ClaudeMarais/AlfaRomeoGiulia_DashboardInfo_ESP32-S3/README.md

# Display info on dashboard of Alfa Romeo Giulia using ESP32-S3
 
An Arduino project to display useful information like turbo boost pressure, current gear, performance tune status, etc., directly on the dashboard of an Alfa Romeo Giulia. The information is displayed in the location on the instrument cluster where the infotainment information is normally displayed, e.g. displaying the radio station name.

A big thank you to the Alfisti community for reverse enginering some of these PIDs, especially Gaucho https://github.com/gaucho1978/BACCAble

| Example Message | Description |
|---|---|
| 23 psi &nbsp; D2 &nbsp; Eng 200*F | While driving, show turbo boost pressure, current gear and engine temp |
| 23 psi &nbsp; D2 &nbsp; Oil 200*F | While driving, show turbo boost pressure, current gear and engine oil temp |
| 23 psi &nbsp; D2 &nbsp; Bat 12.6V | While driving, show turbo boost pressure, current gear and battery voltage |
| 23 psi &nbsp; D2 &nbsp; Squadra | If in Dynamic drive mode and oil temp is above 70*C, the Squadra performance tune is fully enabled |
| Max 23 psi @ 5200 rpm D2 | When car is just idling, e.g. at red traffic light, show interesting information when max turbo boost was measured |
| Battery is low! &nbsp;12.2V | A warning message when the car battery is lower than 12.4V |
| Careful, engine is cold | A warning message when engine speed is higher than 3000 RPM while the engine oil temperature is below 70*C |
| Eng temp too high 248*F | A warning message when the engine coolant temperature is too high (above 120*C / 248*F) |
| Oil temp too high 275*F | A warning message when the engine oil temperature is too high (above 135*C / 275*F) |
| Turbo cooling down 1:12 | A countdown timer roughly estimating for how long the car has to idle for a turbo cooldown after a spirited drive  |

Car data like RPM and boost pressure can be retrieved from the high speed CAN bus, but sending text to the dashboard uses the low speed CAN bus. Since one CAN controller can only communicate on one CAN bus, we require two CAN controllers. The ESP32-S3 has a built-in CAN controller, so we connect a SN65HVD230 CAN transceiver to the ESP32-S3 which communicates on the high speed bus. A separate MCP2515 CAN bus controller with its own TJA1050 transceiver is used to communicate on the low speed CAN bus. The ESP32-S3 has two cores, so it's convenient to continuously collect car data on one core from the high speed CAN bus, while at the same time send information to the dashboard on the low speed CAN bus using the other ESP32-S3 core.

The OBD2 connector has an always-on 12V pin where the device will be powered from. Since it's always on, it will unnecessarily draw power when the car is turned off. One option would be to just always unplug the device when not driving, another might be to add a button to the device to manually switch it on/off. In this project, we simply detect if the car is turned on and if not, we put the device into deep sleep mode to heavily reduce the amount of power used. We'll check for 5 seconds if the car is on, then sleep for 12 seconds, etc. While trying to see if the car turns on, the device will draw ~40mA/190mW, but only ~1mA/1mW while in deep sleep.

NOTE: If you intend to experiment and make your own code changes, I recommend enabling the C++ define for DISABLE_POWER_SAVING_CHECKS found in the file AlfaRomeoGiulia_DashboardInfo_ESP32-S3.ino. If not, the device will go into deep sleep and you might struggle to upload code to the device, since you have to time it just right. When the device is powered on by plugging it into the computer's USB port, you have 5 seconds before it goes into deep sleep. You want to have the device awake while the code is being uploaded. When using the Arduino IDE, I find that if you unplug the device from your computer's USB port, then wait for the message in the Output window that says "Linking everything together...", and then quickly plug the device into your computer's USB port, it gives enough time for the device to stay awake to upload the code.

NOTE: It's fun to tinker with your car, but there is always a chance to mess things up. I won't be liable if for some reason you damage your car.

NOTE: The CAN IDs and PIDs used in this project specifically work with a 2019 Alfa Romeo Giulia 2.0L (Petrol). It's highly unlikely that the same PIDs will work with another car, you'll have to research what PIDs work with your own car.

Some tips:

 - Consider connecting your car to a battery charger while experimenting. It's highly likely that you'll spend several hours in your car while the battery is being drained.
 - Diagrams of OBD2 pins are normally shown for the female connector in your car. Don't forget that those pins are in swapped/mirrored positions on the male connector.
 - The OBD2 connector has an "always on" 12V pin. Make sure the wire connecting to that pin on your male connector isn't exposed so that it cannot touch other wires!
 - I tried multiple pins on the ESP32-S3 to connect to the SN65HVD230, but only D4/D5 worked for me. Coincidentally these are also the SDA/SCL pins.
 - Check if your car has an OBD2 Security Gateway (SGW). If so, you need to install a SGW Bypass module before you to send/receive OBD2 frames to your car.
 - For 3D printing, use something like PETG or TPU which is much more resistant to heat than PLA.

Hardware:
 - XIAO ESP32-S3
 - 12V to 5V Voltage regulator
 - SN65HVD230 CAN bus transceiver
 - MCP2515 CAN bus controller

Arduino libraries used:
 - ESP32-TWAI-CAN: https://github.com/handmade0octopus/ESP32-TWAI-CAN
 - MCP2515: https://github.com/codeljo/AA_MCP2515

If you are unfamiliar with Arduino, it’s pretty simple and there is a multitude of small tutorials on the internet. At a high level, you will need to:
-	Install the Arduino IDE - https://www.arduino.cc/en/software
-	Configure Arduino IDE for ESP32 - https://randomnerdtutorials.com/installing-esp32-arduino-ide-2-0/
-	Install the two libraries mentioned above - https://docs.arduino.cc/software/ide-v1/tutorials/installing-libraries/
-	Try out the most simple ESP32-S3 app to switch on its onboard LED - https://youtu.be/JlnV3U3Rx7k?si=xF3rMG3LD-cYAaQe
-	Perhaps first try out my simple test that writes out car information to your PC - https://github.com/ClaudeMarais/Simple_OBD2_for_AlfaRomeoGiulia

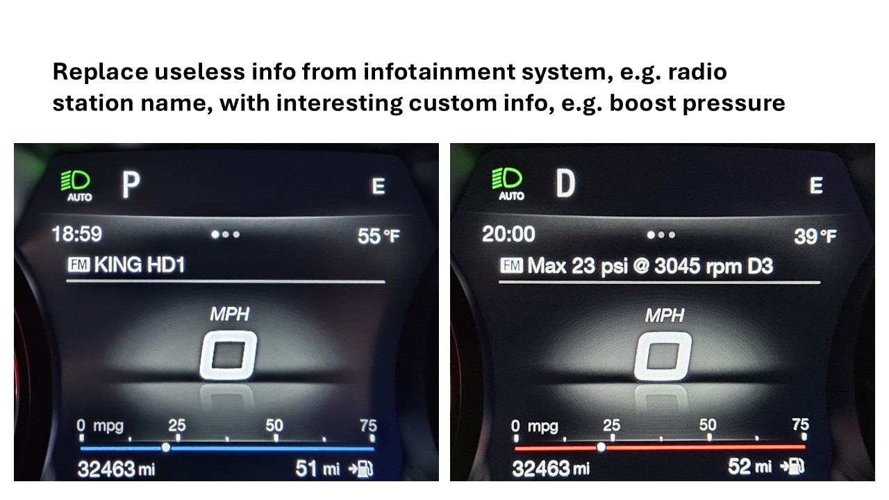
[picture p1: Images/Intro.jpg]
Intro


--------------------------------

Example 1: Turbo boost pressure and currently engaged gear is displayed while driving. When car only idles, max boost pressure info (or warning messages) is displayed. Here it also indicates that the Squadra performance tune is fully enabled, since the engine oil is above 70*C and the car is in Dynamic drive mode.

Demo_MaxBoostPsi

--------------------------------

Example 2: When engine is still cold and RPM is above 3000, show a cautionary warning message while driving and when idling.

Demo_ColdEngine

--------------------------------

Some example messages:

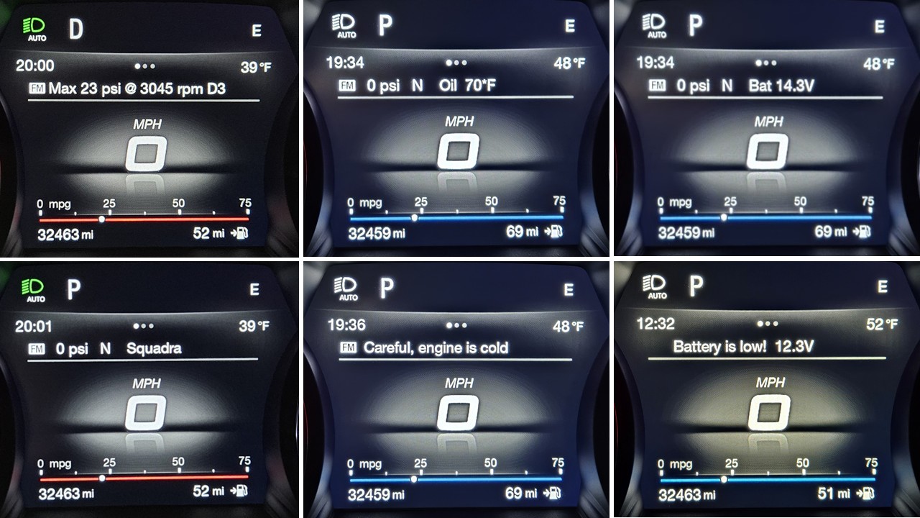
[picture p2: Images/Examples.jpg]
Examples


--------------------------------

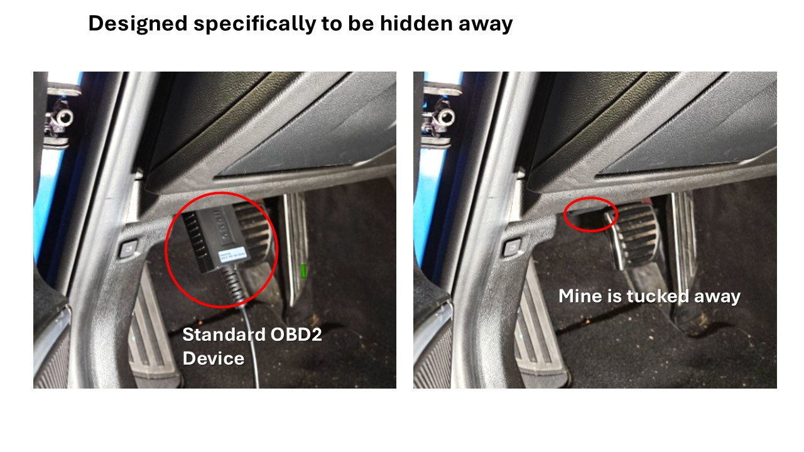
[picture p3: Images/Design.jpg]
Design


--------------------------------

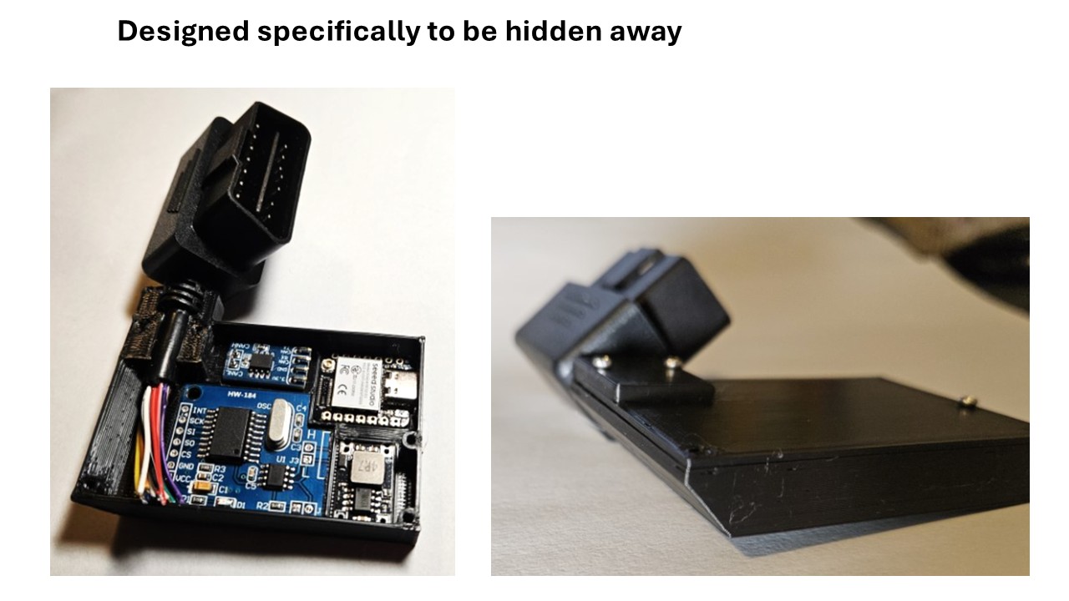
[picture p4: Images/Design2.jpg]
Design2


--------------------------------

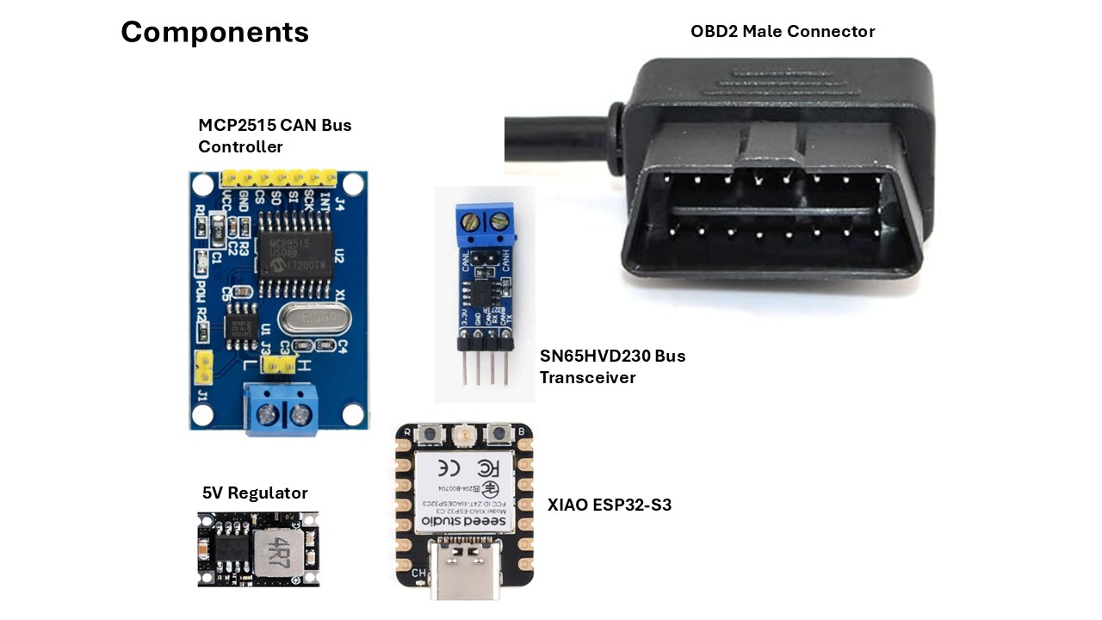
[picture p5: Images/Components.jpg]
Components


--------------------------------

NOTE: I opened up two different OBD2 cables and both had the same color coded thin wires, e.g. the yellow wire is connected to pin 11. But, it might be good to check if your wires are color coded the same way using a multimeter. This video might be helpful: https://youtu.be/-5xS5c7USjE?si=0HzdZcqJ7PLiXYwY

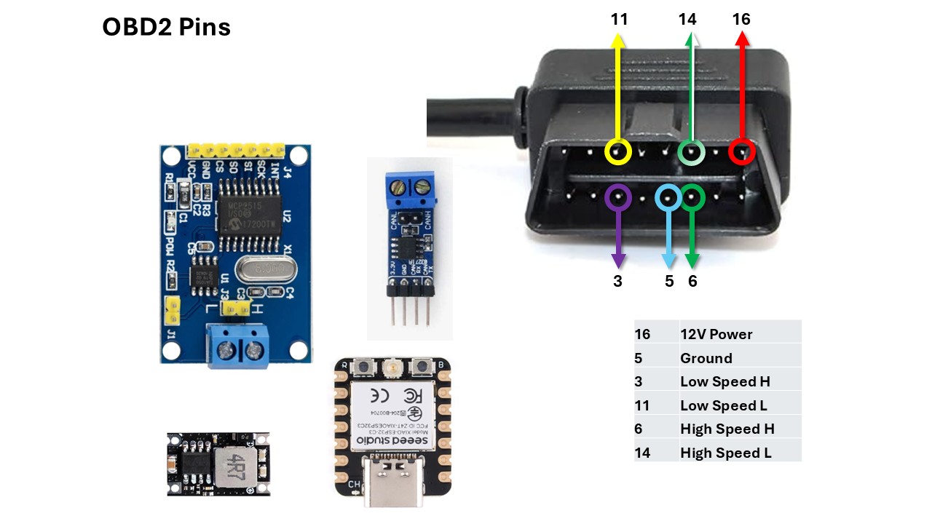
[picture p6: Images/OBD2_Pins.jpg]
OBD2_Pins


--------------------------------

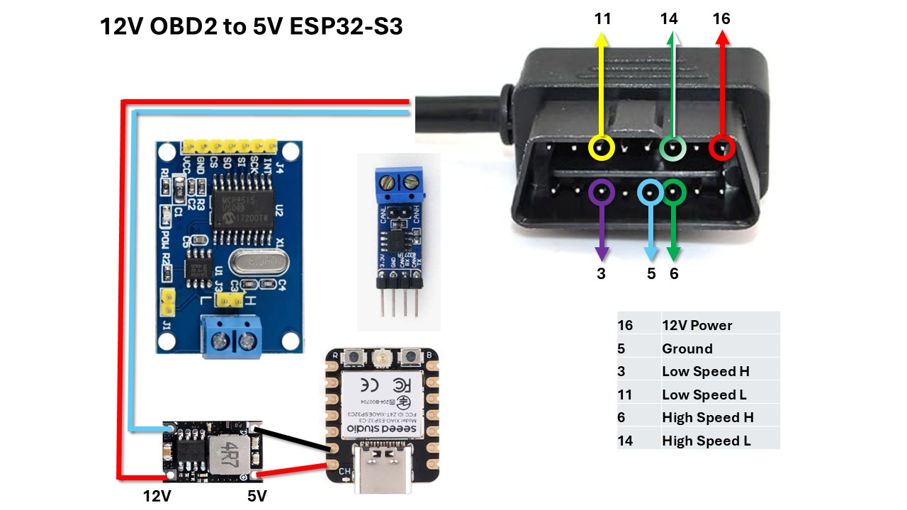
[picture p7: Images/Power.jpg]
Power


--------------------------------

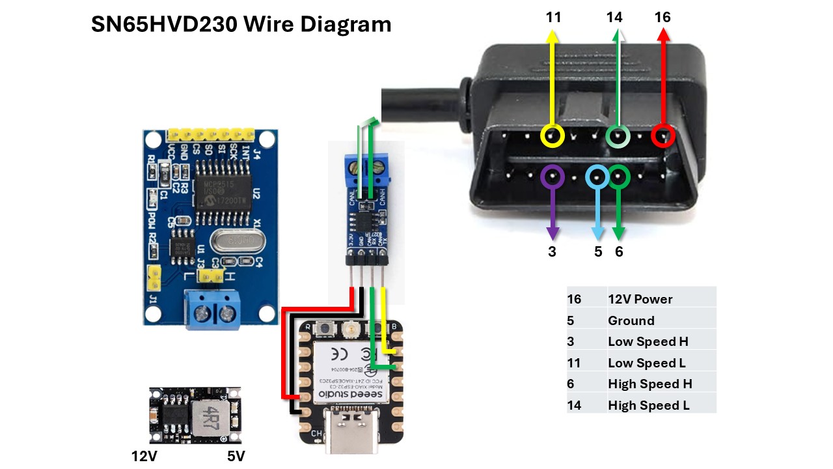
[picture p8: Images/SN65HVD230_Wire_Diagram.jpg]
SN65HVD230_Wire_Diagram


--------------------------------

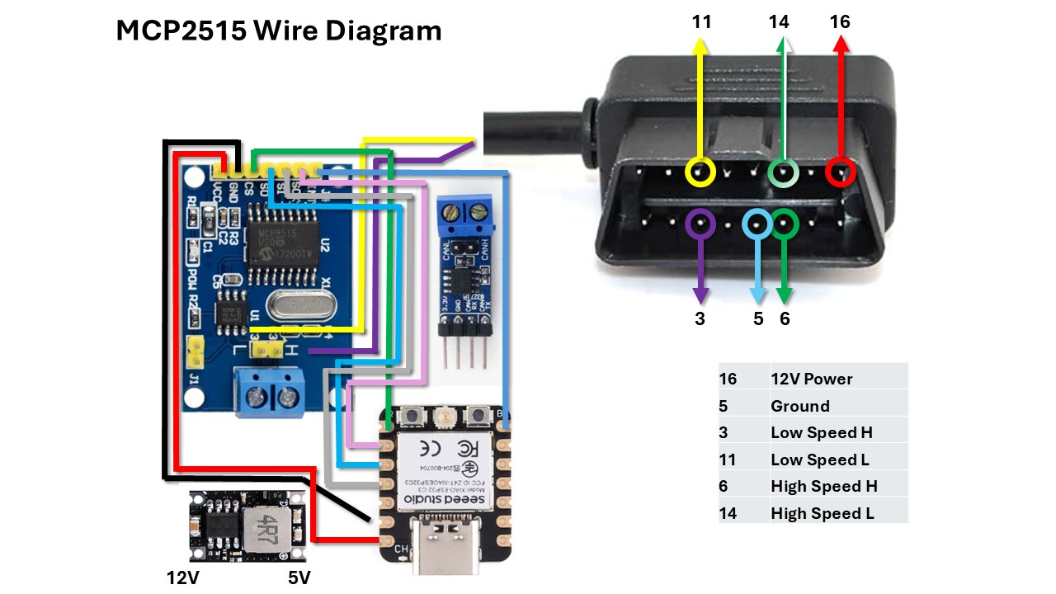
[picture p9: Images/MCP2515_Wire_Diagram.jpg]
MCP2515_Wire_Diagram


--------------------------------

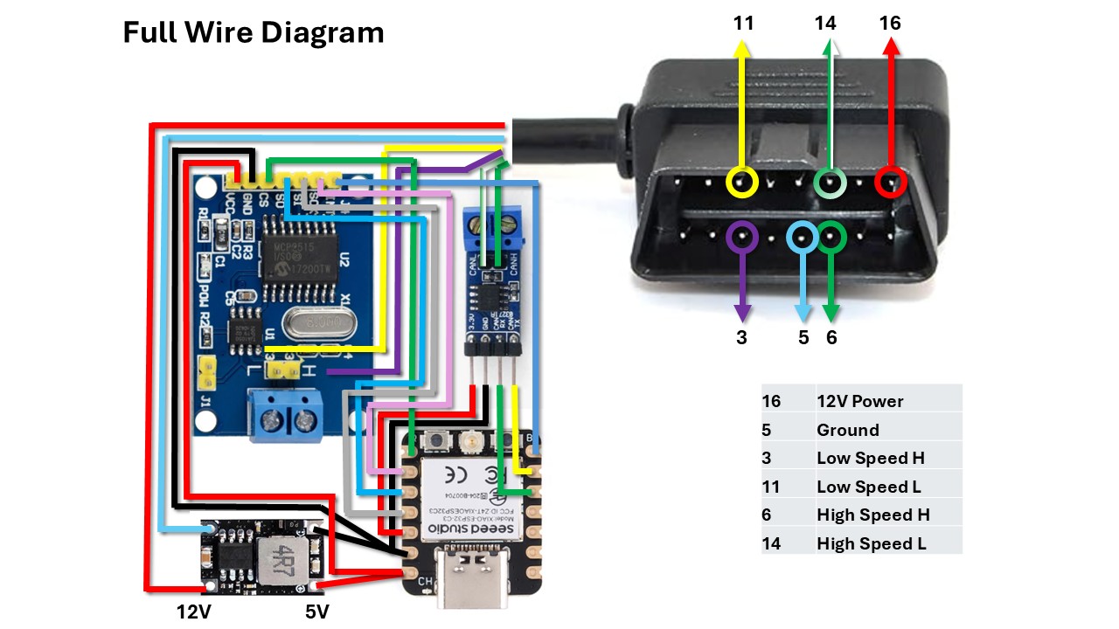
[picture p10: Images/Full_Wire_Diagram.jpg]
Full_Wire_Diagram


--------------------------------

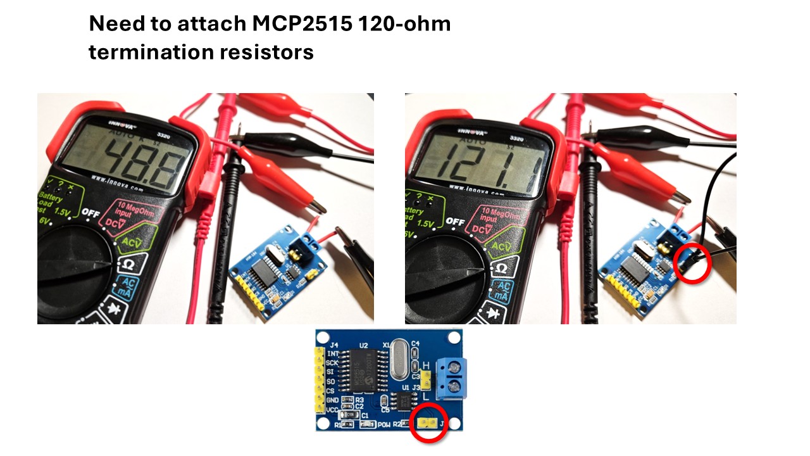
[picture p11: Images/TerminationResistors.jpg]
TerminationResistors


--------------------------------
This isn't required, but I wanted to make the footprint of the device smaller, so I cut off some pieces on the SN65HVD230 and MCP2515.

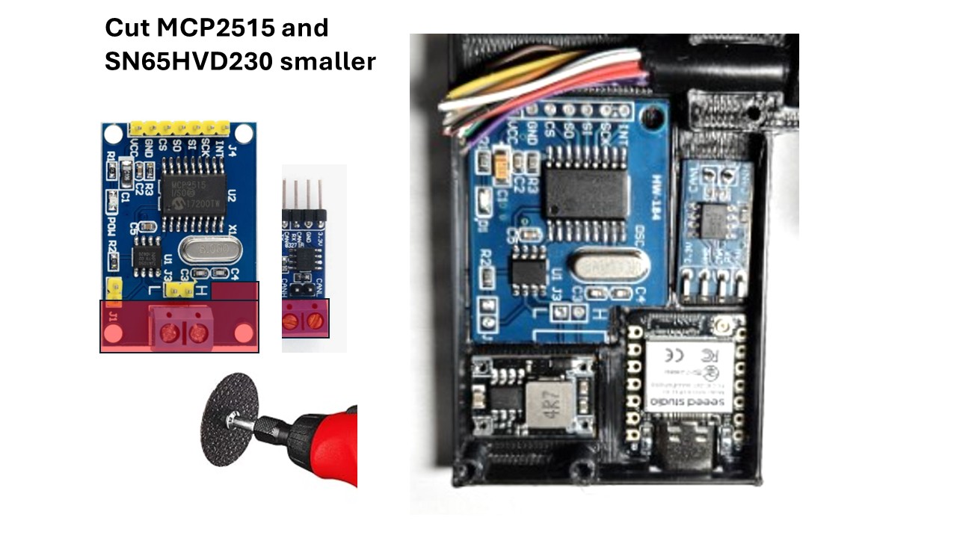
[picture p12: Images/CutSmaller.jpg]
CutSmaller


--------------------------------

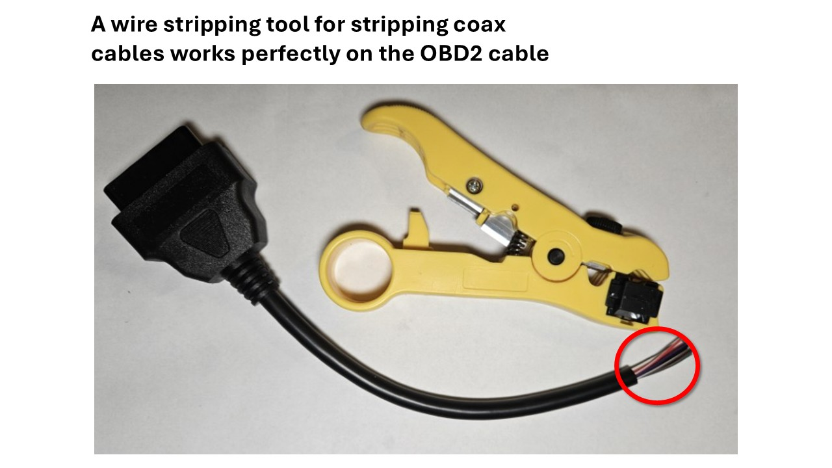
[picture p13: Images/WireStrippingOBD2Cable.jpg]
WireStrippingOBD2Cable
