ClaudeMarais/AlfaRomeoGiulia_DashboardInfo_ESP32-S3/(threads)

Thread 1 (2025-04-23):

sn65hvd230 strange behaviour

backhack99, 2025-04-23:
Hi, if you don't mind,

can i ask you if you had strange behaviour with the sn65?

personally i'm facing problems with receiving corrupted IDs (eg. 0X0F1 instead of 0X9F1).

I'm sending message with an mcp2115 to simulate the car, the only way to keep the integrity of the id is to send every 10ms.

 if try to receive with an mcp2115 instead, no problem, can handle message even if i send them every loop cycle.

on the car side, the sn65 will not see nothing while with the mcp no problem reading the can bus.

hope we can get some answers for those who got problem like this.

Thankss

ClaudeMarais, 2025-04-26:
Hi,

I haven't experienced any problems with sn65, but I did have a weird problem with a mcp2515. The first mcp2515 I tried didn't want to work correctly with 5V, only 3.3V, which is not in accordance with the spec. It might just be that you have a bad unit. These parts are very cheap, and perhaps do not go through vigorous quality control.

backhack99, 2025-04-28:
Hi, thanks for sharing your experience.

I think i found all the answers,
today i will do some tests and then share here so i can save someone's headache.

backhack99, 2025-04-29:
Ok so from my testing this are the results.

there are different types of can following different ISO rules.

the SN65 follows the ISO 11898-2 (High Speed CAN) in fact i was able to read from obd without problem but is not able to read the Slow Speed CAN (ISO 11898-3).

the mcp2515 can read both, but i believe there is some chip like the sn65 but able to read slowcan, i will research and test.

i hope this can be helpfull for somebody.

Thanks

ClaudeMarais, 2025-05-03:
Wow, great info. I guess I got lucky by deciding to use the SN65 on the high speed bus.

Closed 2025-04-29.
