ClaudeMarais/AlfaRomeoGiulia_DashboardInfo_ESP32-S3/(commit log)

2025-02-09 Update v1.2
    Use Media "channel" for front USB to send custom messages to avoid radio station info to interfere with custom messages that can cause flickering
    [DisplayInfoOnDashboard.h, Version.h]
2025-02-14 Update v1.3
    - Fix text flickering and display sometimes freezing, by resetting custom text sequences when frames from radio is observed
    - Small doc update about wire stripping OBD2 cables
    [AlfaRomeoGiulia_DashboardInfo_ESP32-S3.ino, DisplayInfoOnDashboard.h, Version.h]
2025-02-20 Update v1.4
    Reduce CAN bus traffic by only resetting custom text sequences when seeing the *last* radio frame, not each one
    [DisplayInfoOnDashboard.h, Version.h]
2025-02-21 Minor bug fix
    Minor compile error bug fix
    [DisplayInfoOnDashboard.h]
2025-02-27 Update v1.5
    Add an estimated cooldown timer to know how long to wait until the turbo has cooled down after a spirited drive. This uses a combination of Exhaust Gas Temp, Engine RPM and Boost psi.
2025-04-02 Update v1.6
    - Fix Bluetooth music sometimes freezing the display
    -Reduce flickering caused by corrupted or lost CAN frames, by resetting the custom text sequence whenever a transmit CAN error is observed
    - Some code cleanup
    [AlfaRomeoGiulia_DashboardInfo_ESP32-S3.ino, CollectCarData.h, DisplayInfoOnDashboard.h, HandleLowPowerState.h, Shared.h, Version.h]
2026-07-09 Update v1.7
    Add warnings about engine oil and engine temp too high, as well as some minor potential timeout errors for the CAN frame communications
    [CollectCarData.h, DisplayInfoOnDashboard.h, HandleLowPowerState.h, ProcessCarData.h, Shared.h, Version.h]
